ademuri/pet-robots/README.md

# Pet Robots

Small household robots with personality.
