ademuri/pet-robots/snail-bot/hardware/ref/board.pdf

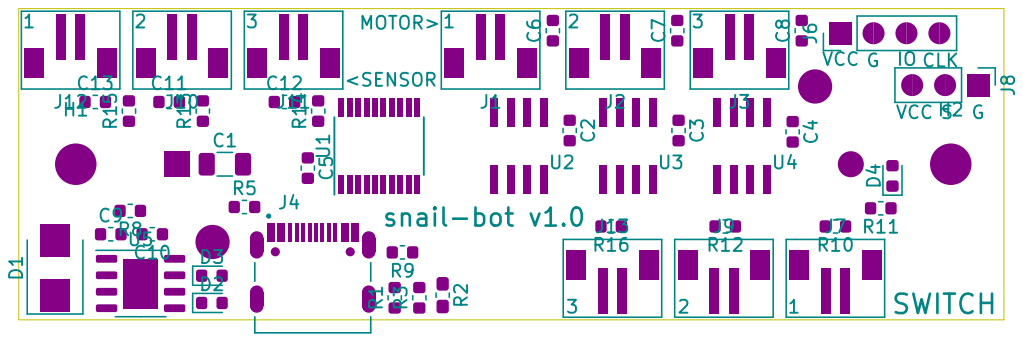
[picture p1: page 1]
