ademuri/pet-robots/snail-bot/hardware/ref/snail-bot.pdf

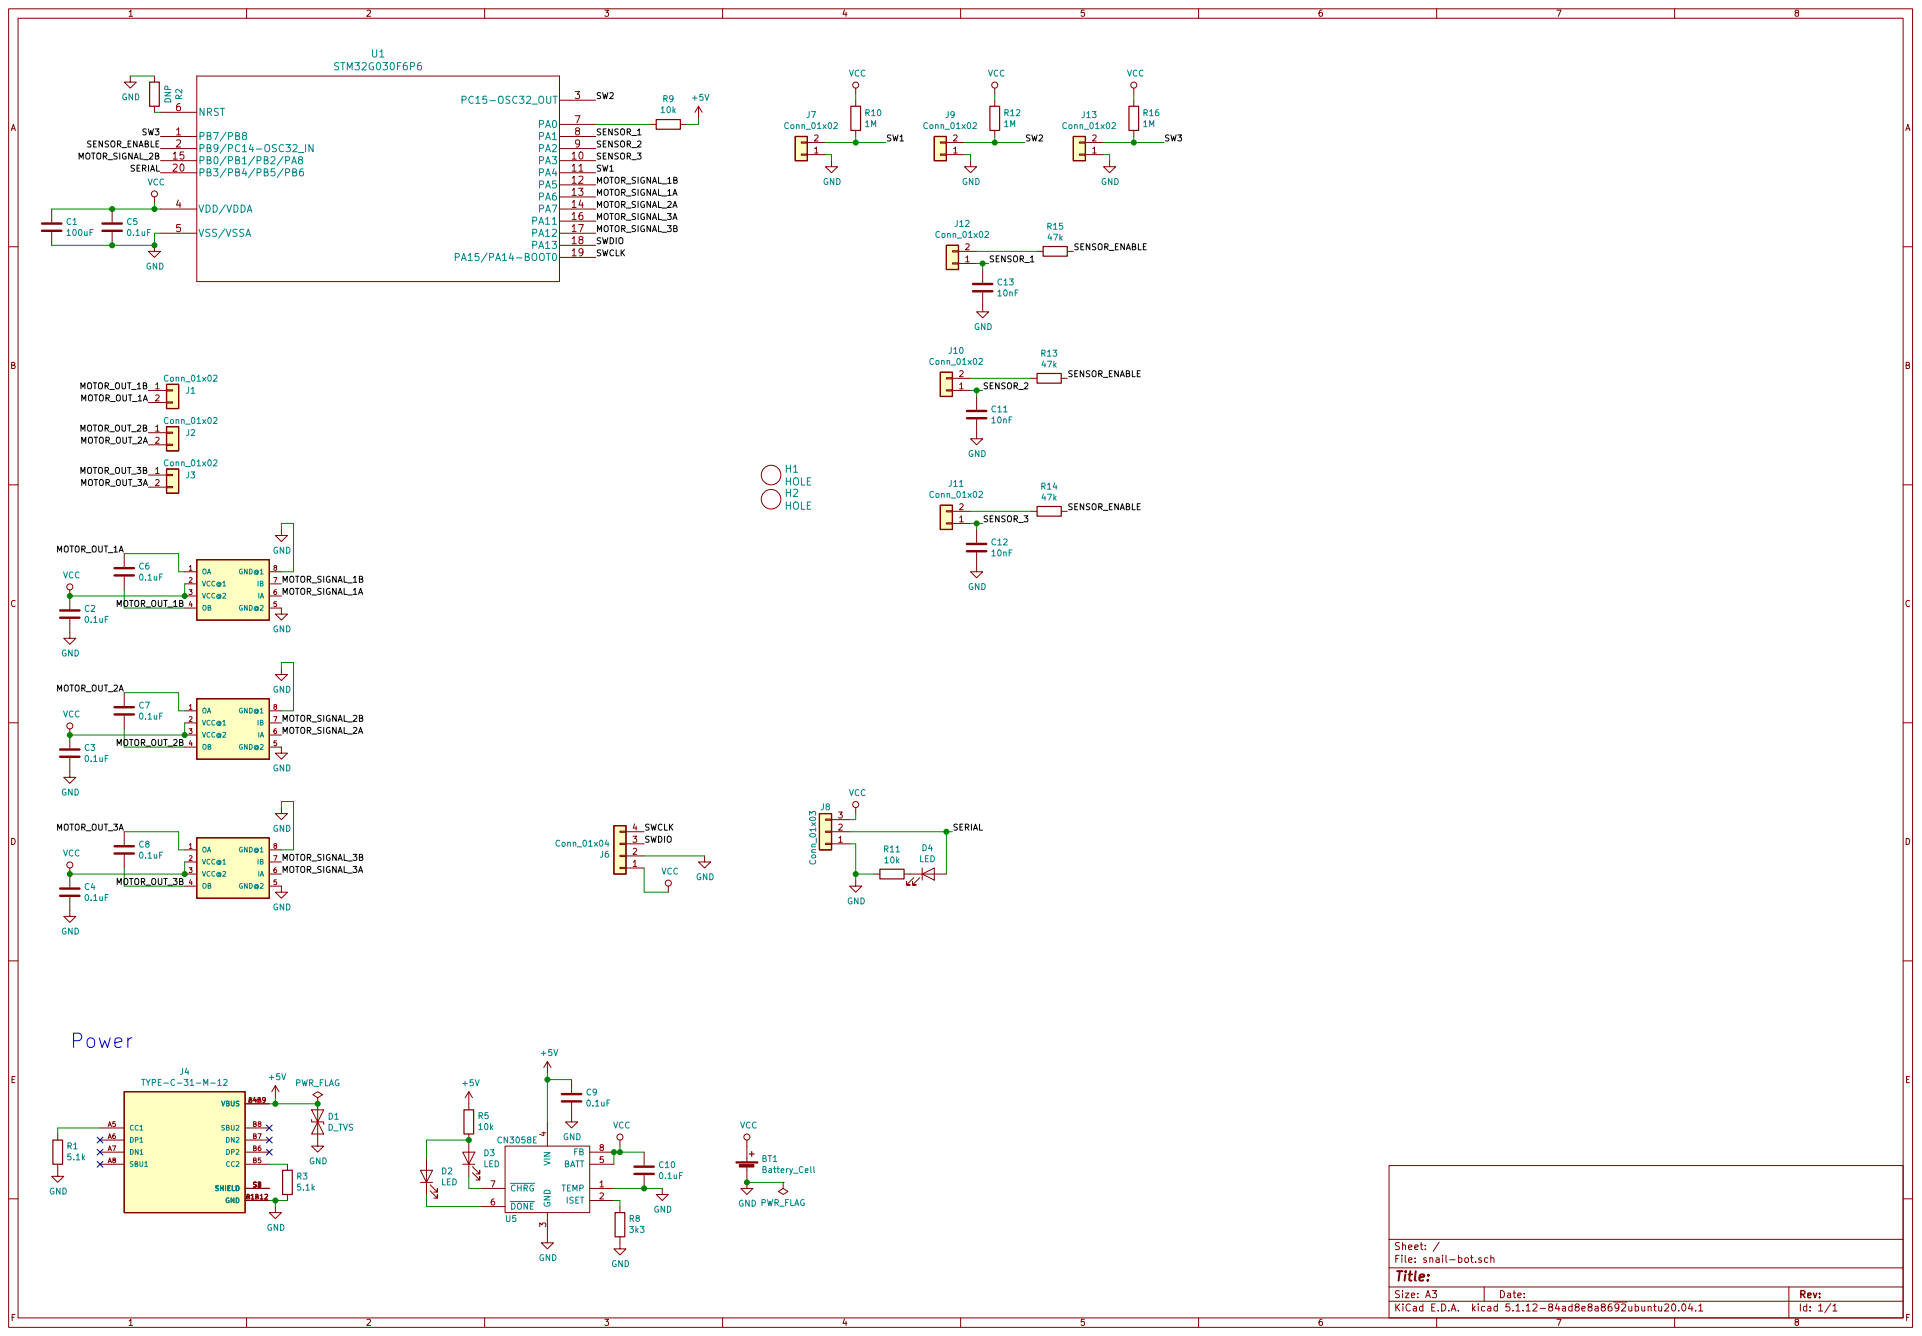
[picture p2: page 1]

Id: 1/1 Title: File: snail-bot.sch Sheet: / R11

4 BATT 5 DONE 6 CHRG 7 FB 8 U5 CN3058E
