ademuri/pet-robots/snail-bot/hardware/snail-bot.kicad_pcb

## KiCad design snail-bot/hardware/snail-bot.kicad_pcb (2021-11-20)

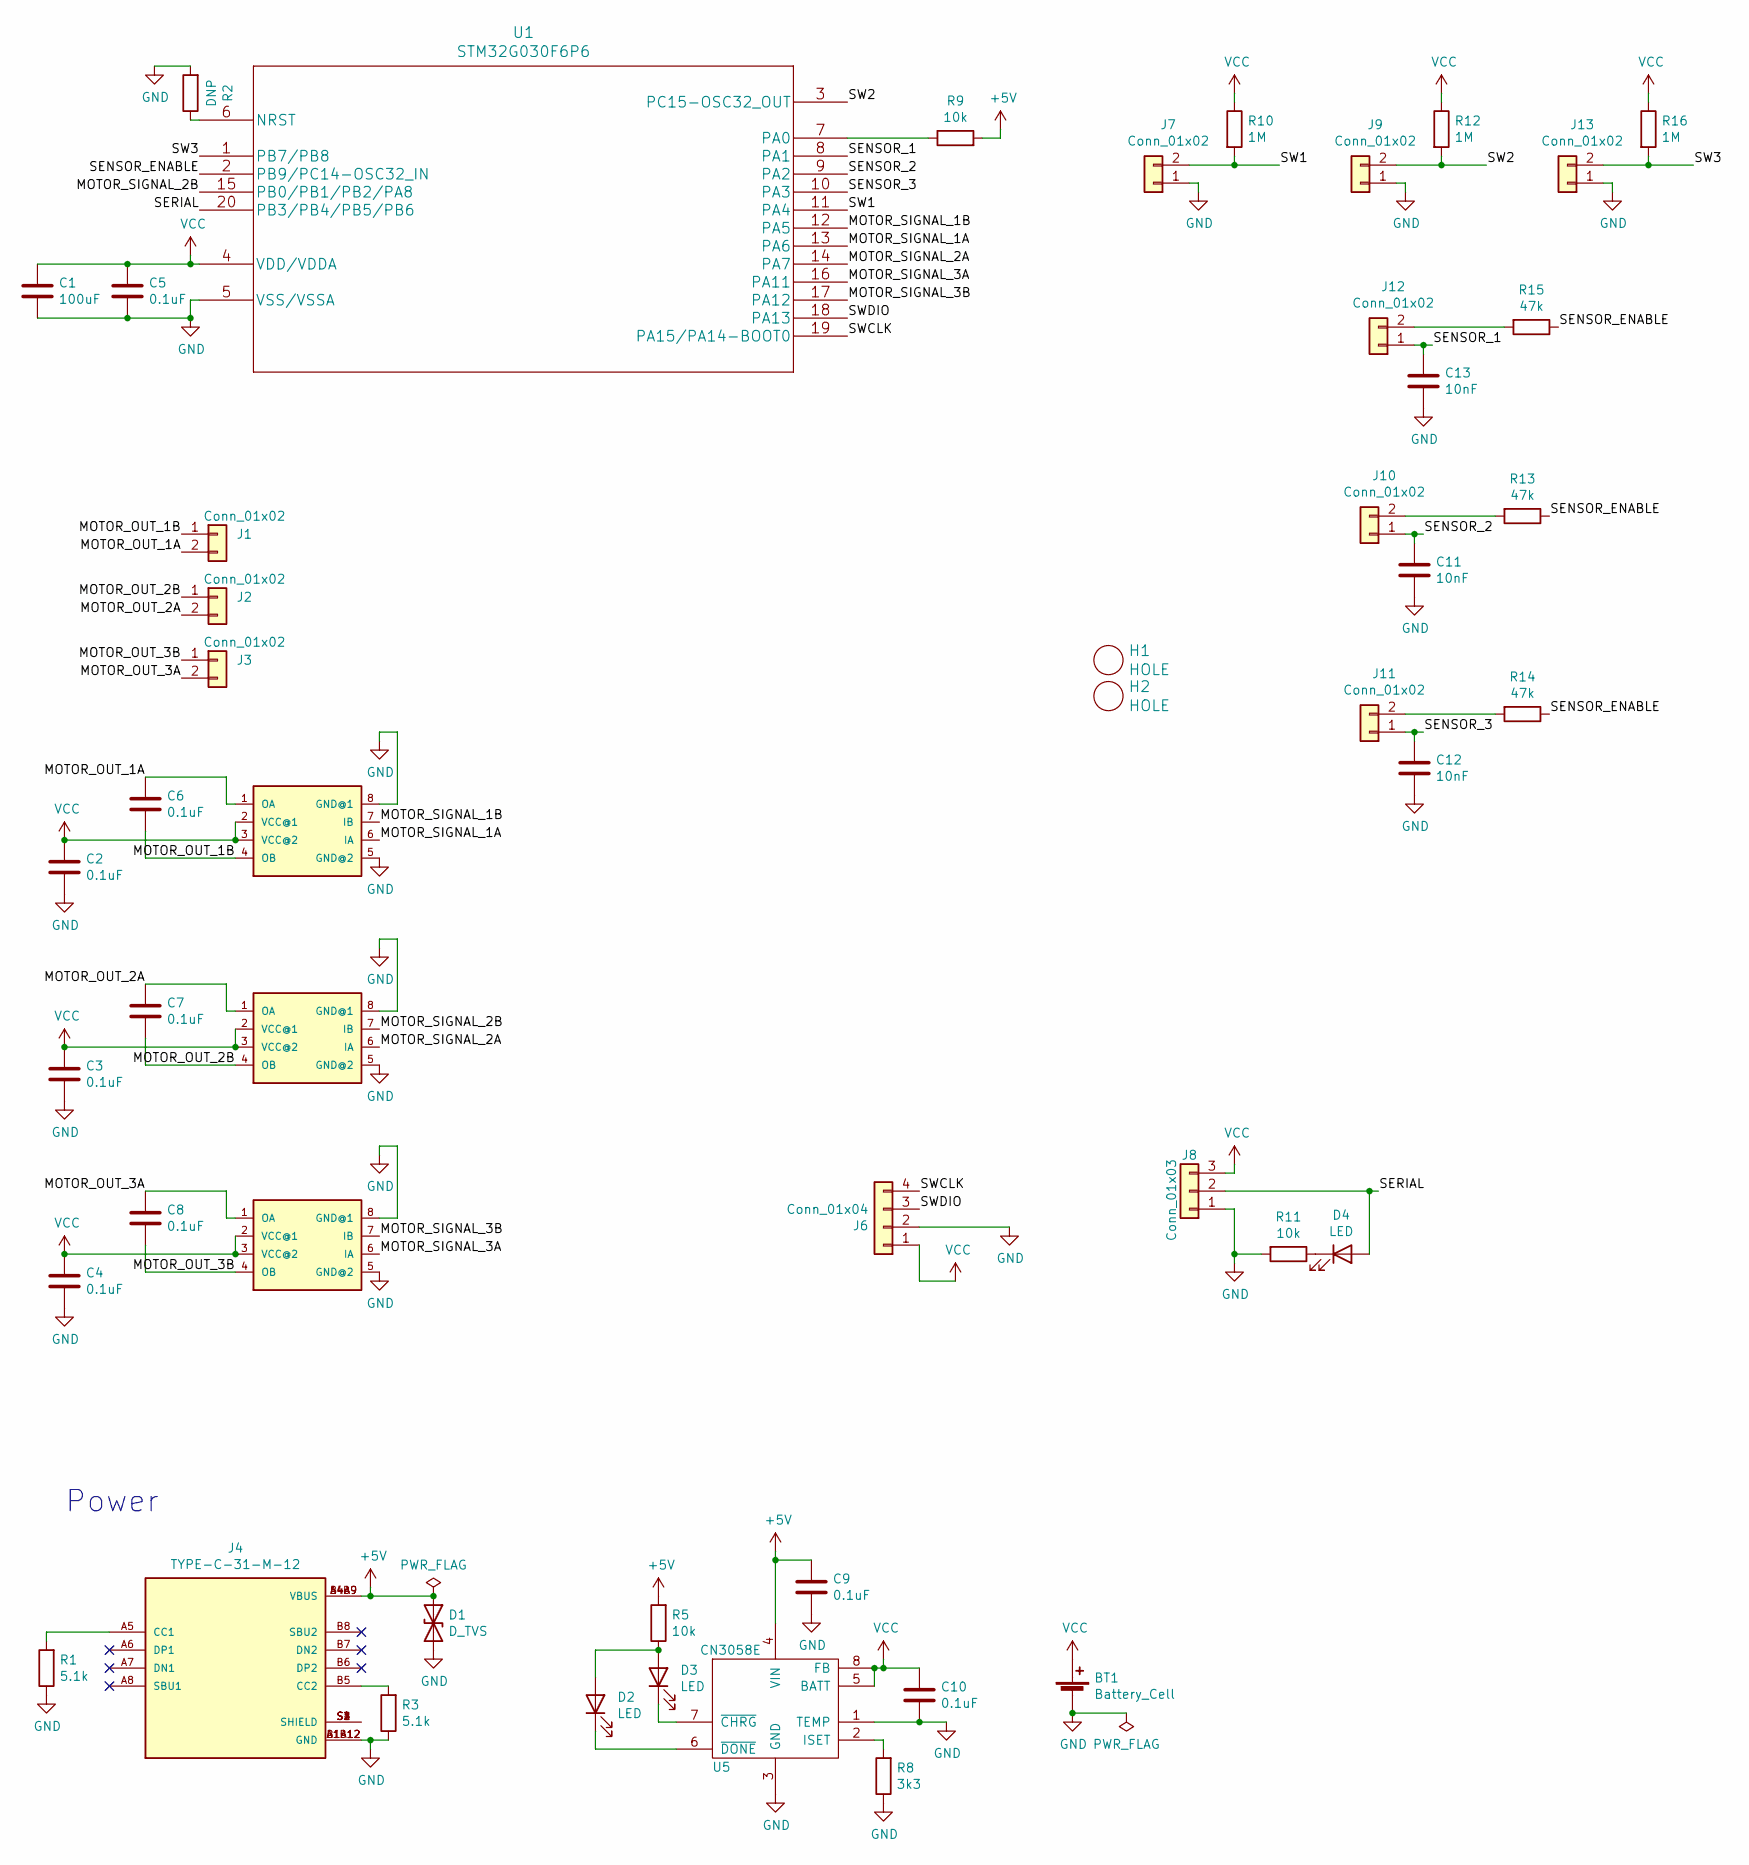
[picture p3: schematic snail-bot.sch]

Parts:
BT1: Battery_Cell; BatteryHolder_Keystone_2460_1xAA
C1: 100uF; C_1206_3216Metric; LCSC C15008
C2, C3, C4, C5, C6, C7, C8, C9, C10: 0.1uF; C_0603_1608Metric; LCSC C14663
C11, C12, C13: 10nF; C_0603_1608Metric; LCSC C57112
D1: D_TVS; D_SMB; LCSC C78395
D2: LED; LED_0603_1608Metric; LCSC C72043
D3, D4: LED; LED_0603_1608Metric; LCSC C2286
H1, H2: HOLE; MountingHole_3.2mm_M3
J1, J2, J3, J7, J9, J10, J11, J12, J13: Conn_01x02; JST_ZH_XKB_SMD_1x02_P1.5mm_Horizontal; LCSC C406141
J4: TYPE-C-31-M-12; HRO_TYPE-C-31-M-12; PARTREV A; LCSC C165948
J6: Conn_01x04; PinHeader_1x04_P2.54mm_Vertical
J8: Conn_01x03; PinHeader_1x03_P2.54mm_Vertical
R1, R3: 5.1k; R_0603_1608Metric; LCSC C23186
R2: DNP; R_0603_1608Metric_Pad1.05x0.95mm_HandSolder
R5, R9, R11: 10k; R_0603_1608Metric; LCSC C25804
R8: 3k3; R_0603_1608Metric; LCSC C22978
R10, R12, R16: 1M; R_0603_1608Metric; LCSC C22935
R13, R14, R15: 47k; R_0603_1608Metric; LCSC C25819
U1: STM32G030F6P6; TSSOP-20_4.4x6.5mm_P0.65mm; LCSC C529330
U2, U3, U4: L9110; SO-08; LCSC C725793
U5: CN3058E; SOP-8_3.9x4.9mm_P1.27mm_Thermal; LCSC C112011

Connections:
+5V: C9.1, D1.1 (A1), J4.A4B9 (VBUS), J4.B4A9 (VBUS), R5.2, R9.2, U5.4 (VIN)
/MOTOR_OUT_1A: C6.1, J1.2, U2.1 (OA)
/MOTOR_OUT_1B: C6.2, J1.1, U2.4 (OB)
/MOTOR_OUT_2A: C7.1, J2.2, U3.1 (OA)
/MOTOR_OUT_2B: C7.2, J2.1, U3.4 (OB)
/MOTOR_OUT_3A: C8.1, J3.2, U4.1 (OA)
/MOTOR_OUT_3B: C8.2, J3.1, U4.4 (OB)
/MOTOR_SIGNAL_1A: U1.13 (PA6), U2.6 (IA)
/MOTOR_SIGNAL_1B: U1.12 (PA5), U2.7 (IB)
/MOTOR_SIGNAL_2A: U1.14 (PA7), U3.6 (IA)
/MOTOR_SIGNAL_2B: U1.15 (PB0/PB1/PB2/PA8), U3.7 (IB)
/MOTOR_SIGNAL_3A: U1.16 (PA11), U4.6 (IA)
/MOTOR_SIGNAL_3B: U1.17 (PA12), U4.7 (IB)
/SENSOR_1: C13.1, J12.1, U1.8 (PA1)
/SENSOR_2: C11.1, J10.1, U1.9 (PA2)
/SENSOR_3: C12.1, J11.1, U1.10 (PA3)
/SENSOR_ENABLE: R13.1, R14.1, R15.1, U1.2 (PB9/PC14-OSC32_IN)
/SERIAL: D4.2 (A), J8.2, U1.20 (PB3/PB4/PB5/PB6)
/SW1: J7.2, R10.2, U1.11 (PA4)
/SW2: J9.2, R12.2, U1.3 (PC15-OSC32_OUT)
/SW3: J13.2, R16.2, U1.1 (PB7/PB8)
/SWCLK: J6.4, U1.19 (PA15/PA14-BOOT0)
/SWDIO: J6.3, U1.18 (PA13)
GND: BT1.2 (-), C1.2, C2.2, C3.2, C4.2, C5.2, C9.2, C10.2, C11.2, C12.2, C13.2, D1.2 (A2), J4.A1B12 (GND), J4.B1A12 (GND), J6.2, J7.1, J8.1, J9.1, J13.1, R1.1, R2.2, R3.1, R8.1, R11.2, U1.5 (VSS/VSSA), U2.5 (GND@2), U2.8 (GND@1), U3.5 (GND@2), U3.8 (GND@1), U4.5 (GND@2), U4.8 (GND@1), U5.1 (TEMP), U5.3 (GND)
unnamed: D2.1 (K), U5.6 (~DONE)
unnamed: D2.2 (A), D3.2 (A), R5.1
unnamed: D3.1 (K), U5.7 (~CHRG)
unnamed: D4.1 (K), R11.1
unnamed: J4.A5 (CC1), R1.2
unnamed: J4.B5 (CC2), R3.2
unnamed: J4.S1 (SHIELD), J4.S2 (SHIELD), J4.S3 (SHIELD), J4.S4 (SHIELD)
unnamed: J10.2, R13.2
unnamed: J11.2, R14.2
unnamed: J12.2, R15.2
unnamed: R2.1, U1.6 (NRST)
unnamed: R8.2, U5.2 (ISET)
unnamed: R9.1, U1.7 (PA0)
VCC: BT1.1 (+), C1.1, C2.1, C3.1, C4.1, C5.1, C10.1, J6.1, J8.3, R10.1, R12.1, R16.1, U1.4 (VDD/VDDA), U2.2 (VCC@1), U2.3 (VCC@2), U3.2 (VCC@1), U3.3 (VCC@2), U4.2 (VCC@1), U4.3 (VCC@2), U5.5 (BATT), U5.8 (FB)

Notes on the sheet:
Power

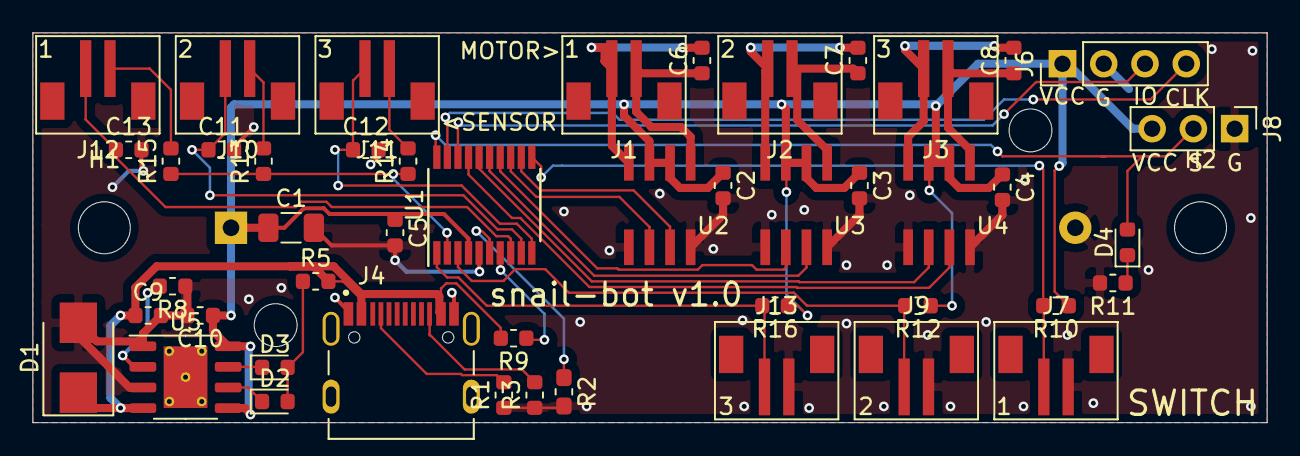
[picture p4: board snail-bot.kicad_pcb from above]

Board: 2 copper layers, 76.0 x 24.0 mm, 50 parts (1 on the bottom side), 38 nets.
