ademuri/pet-robots/snail-bot/src/snail.ino

#include "STM32LowPower.h"

const int kLedPin = PB_3;

const int kMotor1A = PA6;
const int kMotor1B = PA5;
const int kMotor2A = PA7;
const int kMotor2B = PB0;
const int kMotor3A = PA11;
const int kMotor3B = PA12;

const int kSensorEnable = PB9;
const int kSensor1 = PA1;
const int kSensor2 = PA2;
const int kSensor3 = PA3;

const int kSwitch1 = PA4;
const int kSwitch2 = PC15;
const int kSwitch3 = PB7;

// If the device was reset via the NRST pin, just wait to be programmed.
bool pinReset;

void setup() {
  if (__HAL_RCC_GET_FLAG(RCC_FLAG_LPWRRST) || __HAL_RCC_GET_FLAG(RCC_FLAG_PWRRST) || __HAL_RCC_GET_FLAG(RCC_FLAG_SFTRST)) {
    pinReset = false;
  } else {
    pinReset = __HAL_RCC_GET_FLAG(RCC_FLAG_PINRST);
  }
  __HAL_RCC_CLEAR_RESET_FLAGS();
  pinMode(kLedPin, OUTPUT);

  pinMode(kMotor1A, OUTPUT);
  pinMode(kMotor1B, OUTPUT);
  pinMode(kMotor2A, OUTPUT);
  pinMode(kMotor2B, OUTPUT);
  pinMode(kMotor3A, OUTPUT);
  pinMode(kMotor3B, OUTPUT);
  
  pinMode(kSensorEnable, OUTPUT);
  pinMode(kSensor1, INPUT);
  pinMode(kSensor2, INPUT);
  pinMode(kSensor3, INPUT);

  pinMode(kSwitch1, INPUT);
  pinMode(kSwitch2, INPUT);
  pinMode(kSwitch3, INPUT);

  // Use a slow frequency since we're driving motors
  analogWriteFrequency(400);
  digitalWrite(kSensorEnable, HIGH);

  LowPower.begin();

  digitalWrite(kLedPin, HIGH);
  delay(500);
  digitalWrite(kLedPin, LOW);
  delay(500);

 delay(1000);
}

void loop() {
#ifdef   TEST
  test();
#else
  if (pinReset) {
    digitalWrite(kLedPin, HIGH);
    delay(100);
    digitalWrite(kLedPin, LOW);
    delay(100);
  } else {
    digitalWrite(kLedPin, HIGH);
    LowPower.deepSleep(100);
    digitalWrite(kLedPin, LOW);
    LowPower.deepSleep(3000);

    digitalWrite(kLedPin, HIGH);
    delay(300);
    digitalWrite(kLedPin, LOW);
    delay(3000);
  }
#endif
}

void test() {
  const int motorPinA = kMotor1A;
  const int motorPinB = kMotor1B;
  const int sensorPin = kSensor1;
  const int switchPin = kSwitch1;

  uint32_t light = analogRead(sensorPin);
  analogWrite(kLedPin, light);

  const uint8_t speed = 128;

  if (!digitalRead(switchPin)) {
    analogWrite(motorPinA, speed);
    digitalWrite(motorPinB, 0);
  } else {
    analogWrite(motorPinA, 256 - speed);
    digitalWrite(motorPinB, 1);
  }
  delay(5);
}
