ademuri/pet-robots/(commit log)

2021-11-17 Snail-bot schematic mostly finished
    [snail-bot.kicad_pcb, snail-bot.sch]
2021-11-18 Schematic polish
    [snail-bot.sch]
2021-11-18 Finish schematic and associations
    [snail-bot.sch]
2021-11-19 snail-bot v1.0
    [snail-bot-B_Cu.gbr, snail-bot-B_Mask.gbr, snail-bot-B_Paste.gbr, snail-bot-B_SilkS.gbr, snail-bot-Edge_Cuts.gbr, snail-bot-F_Cu.gbr, snail-bot-F_Mask.gbr, snail-bot-F_Paste.gbr]
2021-11-20 Add 3D models
    [snail-bot.kicad_pcb, snail-bot.sch]
2021-12-12 Move snail-bot board into hardware dir
    [snail-bot-B_Cu.gbr, snail-bot-B_Mask.gbr, snail-bot-B_Paste.gbr, snail-bot-B_SilkS.gbr, snail-bot-Edge_Cuts.gbr, snail-bot-F_Cu.gbr, snail-bot-F_Mask.gbr, snail-bot-F_Paste.gbr]
2021-12-13 Migrate to Arduino
2022-01-02 Add low-power sleep (untested)
2022-01-04 Fix low-power code
    Also add logic to not go to low-power mode if the reset pin was used.
    Without this, it's annoying to reprogram.
    [snail.ino]
2022-01-11 Switch to STM32LowPower library
